cdeeran/bartender/assets/documents/bartender_screen_mount.stl

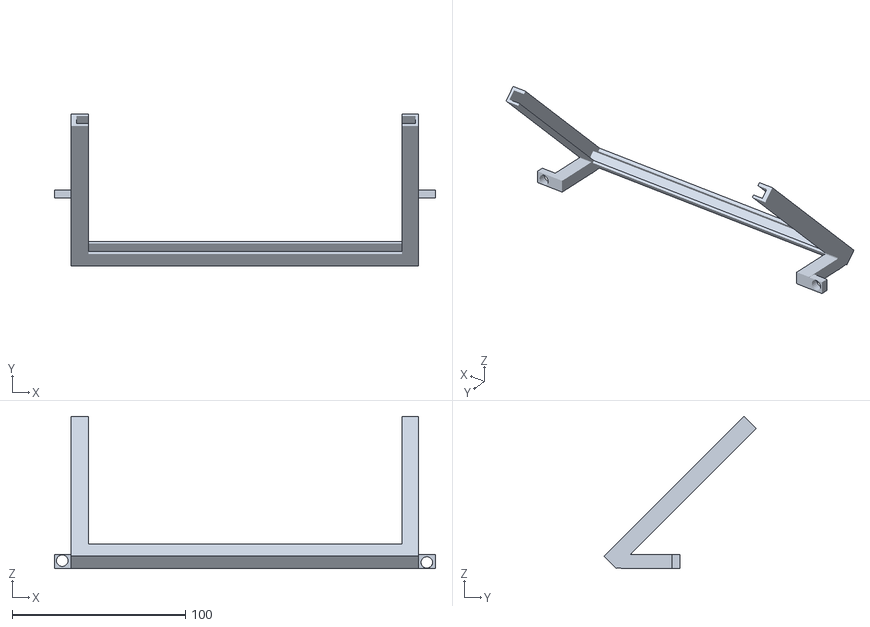
[picture p4: CAD file, 2021-03-01]
assets/documents/bartender_screen_mount.stl
220.2 x 87.9 x 88.1
