cdeeran/bartender/assets/documents/manifold.stl

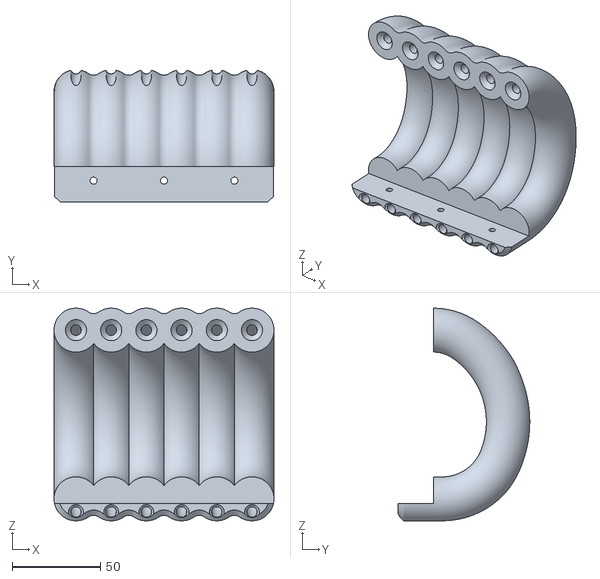
[picture p5: CAD file, 2021-01-24]
assets/documents/manifold.stl
125.0 x 74.7 x 120.9
