cdeeran/bartender/assets/documents/standoff.stl

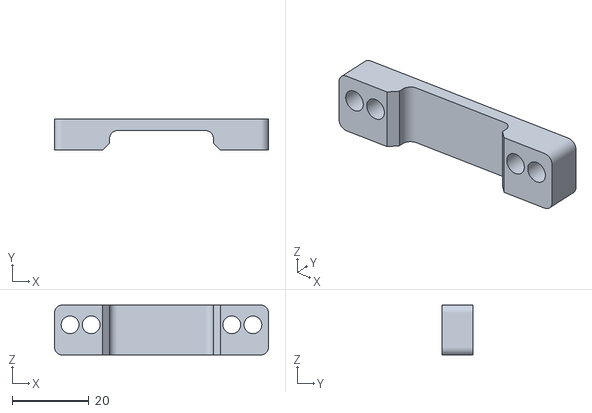
[picture p6: CAD file, 2021-01-24]
assets/documents/standoff.stl
55.7 x 8.00 x 13.0
