cdeeran/bartender/assets/documents/cupholder.stl

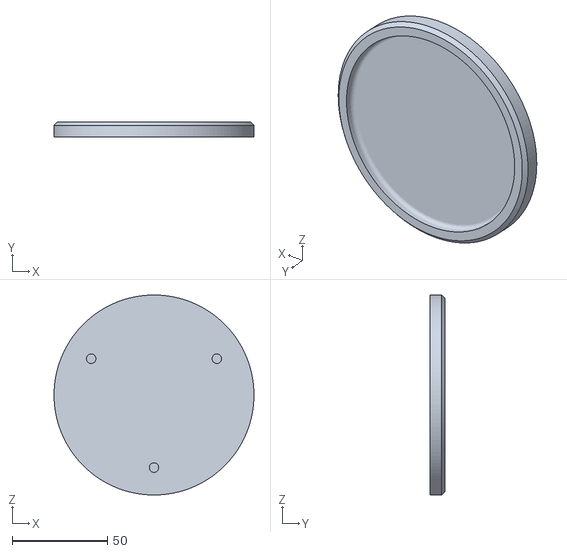
[picture p7: CAD file, 2021-01-24]
assets/documents/cupholder.stl
105.0 x 8.00 x 105.0
