cdeeran/bartender/assets/documents/funnel_holder.stl

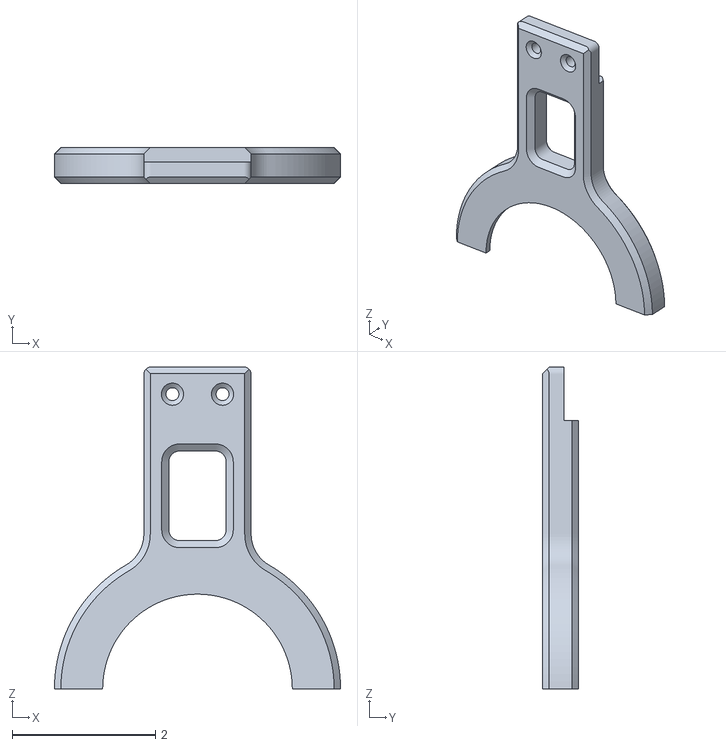
[picture p8: CAD file, 2021-01-24]
assets/documents/funnel_holder.stl
4.00 x 0.5 x 4.50
