cdeeran/bartender/assets/documents/wiring_diagram.png

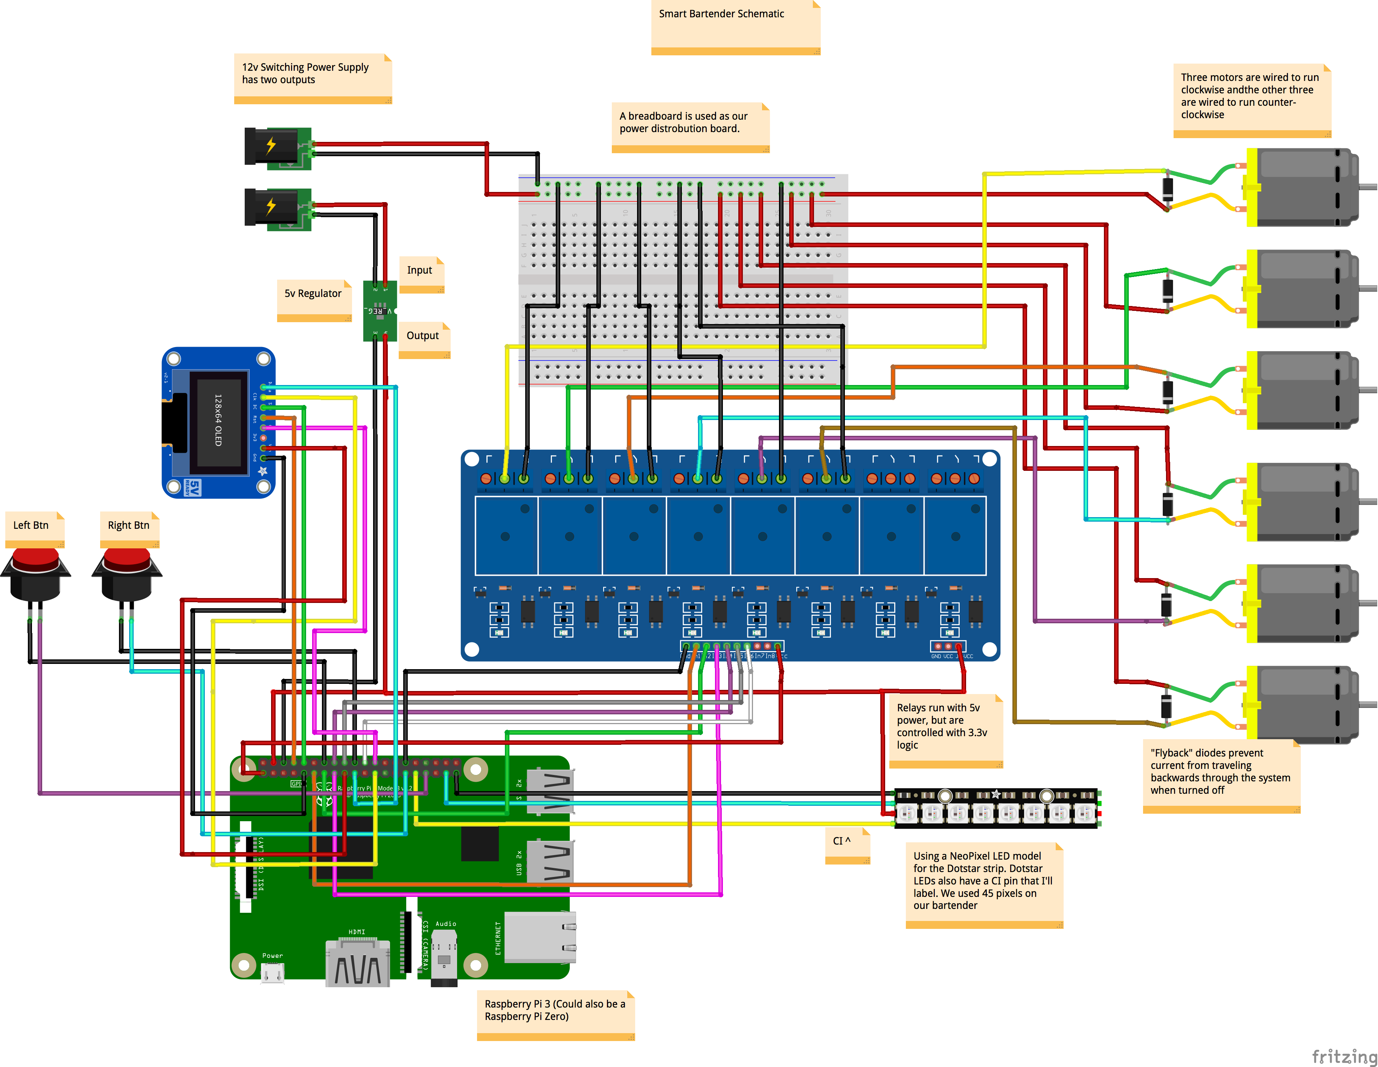
assets/documents/wiring_diagram.png
