cdeeran/bartender/(threads)

Thread 10 (2021-02-28):

Implement "hot" config changes

cdeeran, 2021-02-28:
During use, if a pump was to be changed to a different kind of liquid. There currently is no easy way to have the config file be updated and recognized. Currently, owner would have to update and commit the file changes and then pull down the changes on the PI.

This can be solved by implemented in settings manager and a accessibility keyboard for the user to use to change the liquid at a certain pump.

Closed 2021-05-26.

Thread 8 (2021-02-28):

Motor Malfunctions

cdeeran, 2021-02-28:
3 out of the 6 motors are not functioning. You can hear the GPIO pins drive high, but motors do not receiving power. This needs to be investigated and fixed ASAP.
