cdeeran/bartender/tests/context.py

import os
import sys
sys.path.insert(0, os.path.abspath(
    os.path.join(os.path.dirname(__file__), '..')))

from bartender.bartender      import Bartender
from bartender.thread_manager import ProgressThread
from bartender.thread_manager import PourDrinkThread
from hardware.gpio            import Gpio
from hardware.gpio_sim        import GpioSim
from hardware.pins            import Pins
