cdeeran/bartender/(commit log)

2020-12-25 Fixed GPIO bug and update ip address to PI 4B
    [gpio_sim.py]
2021-01-09 Added new Docs and code for hardware.
    [cupholder.stl, funnel_holder.stl, manifold.stl, screen_mount.stl, standoff.stl]
2021-01-24 adding execution for other pumps.
2021-02-14 GPIO Pin adjustment
2021-03-01 Commit using lfs
    [bartender_screen_mount.stl, cupholder.stl, funnel_holder.stl, manifold.stl, standoff.stl]
2021-03-01 left overs from last commit
    [cupholder.stl, funnel_holder.stl, manifold.stl, screen_mount.stl, standoff.stl]
